billylin14/five_guys_led_cube_projection/README.md

# 5 GUYS LED Cube Projection
A real-time 3D hologram projection project with custom-made 8x8x8 LED cube interfacing with Huzzah Feather ESP32 microcontroller and LabVIEW.
