billylin14/five_guys_led_cube_projection/led_schematics/B layer.png

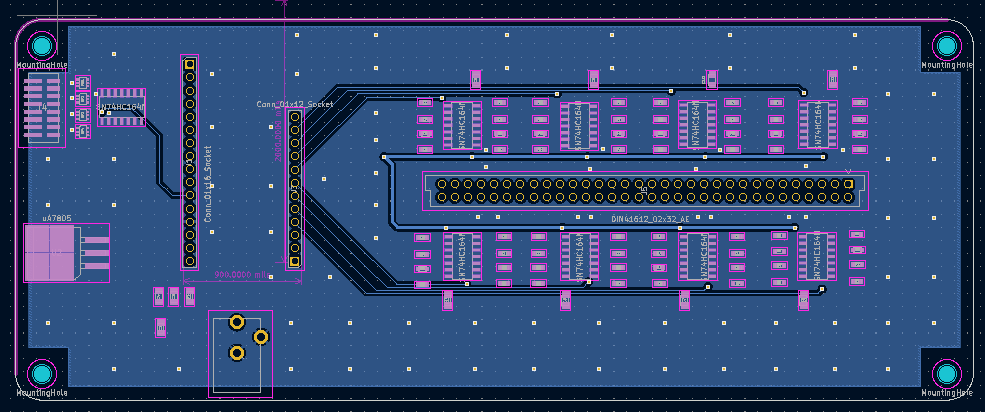
led_schematics/B layer.png
