billylin14/five_guys_led_cube_projection/led_schematics/F Layer.png

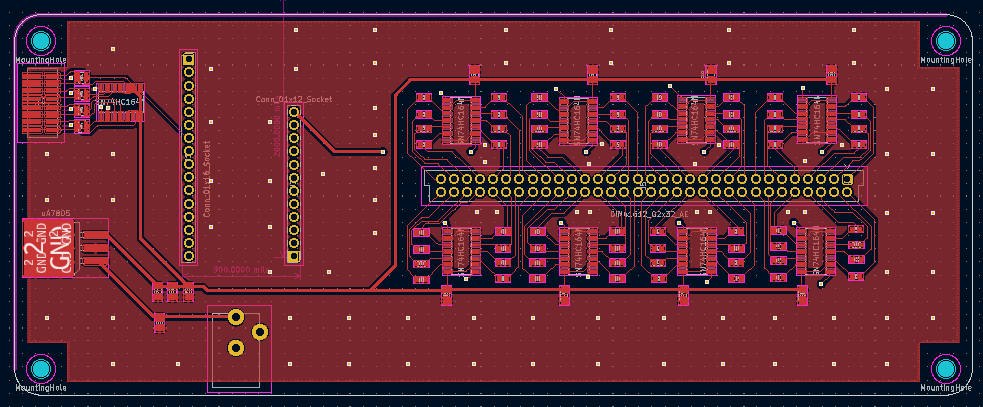
led_schematics/F Layer.png
