billylin14/five_guys_led_cube_projection/led_schematics/Full Layout.png

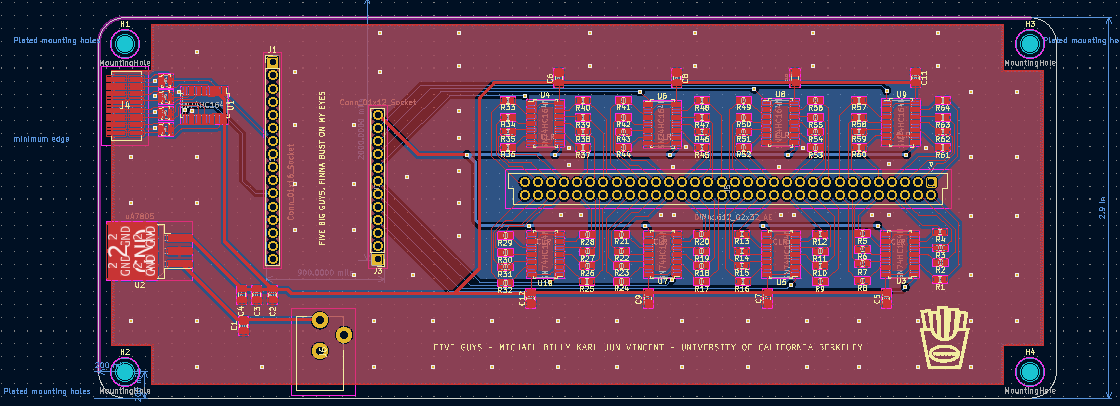
led_schematics/Full Layout.png
