billylin14/five_guys_led_cube_projection/led_schematics/Main Schmtc.png

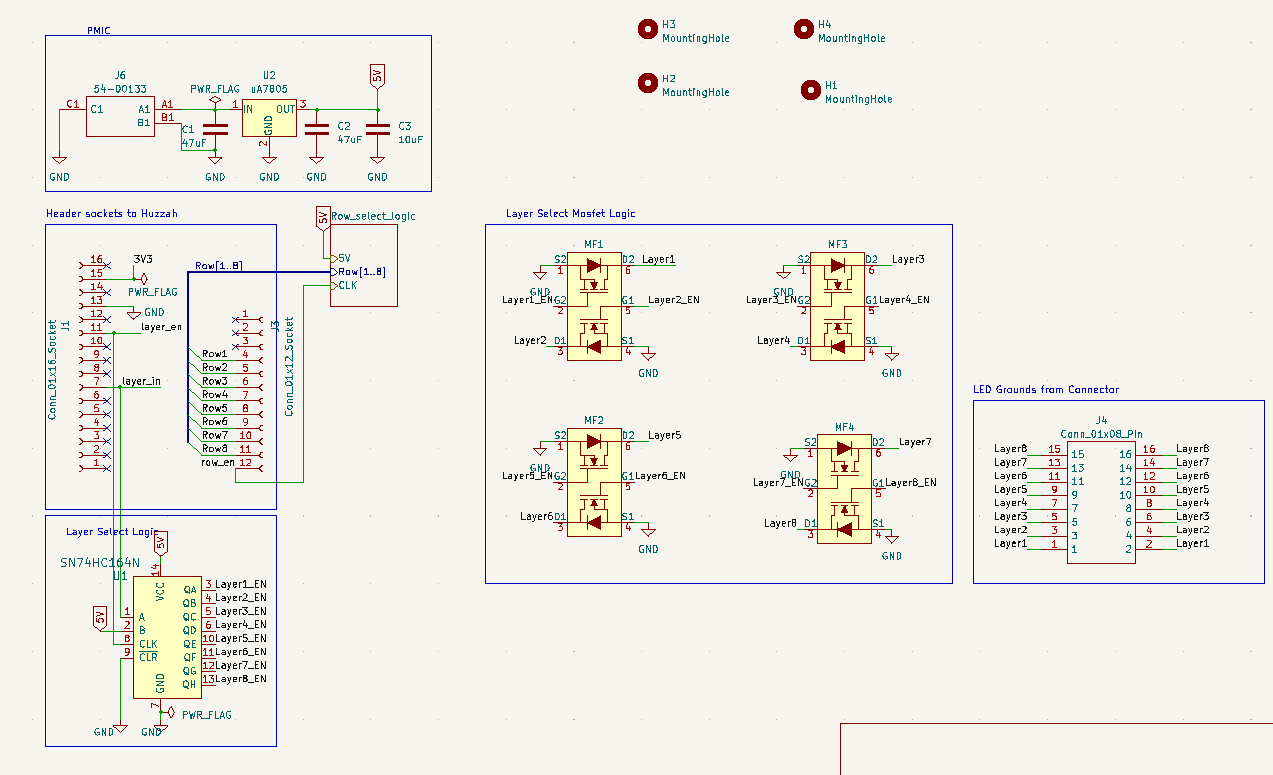
led_schematics/Main Schmtc.png
