billylin14/five_guys_led_cube_projection/led_schematics/Row_slect_logic_Schmtc.png

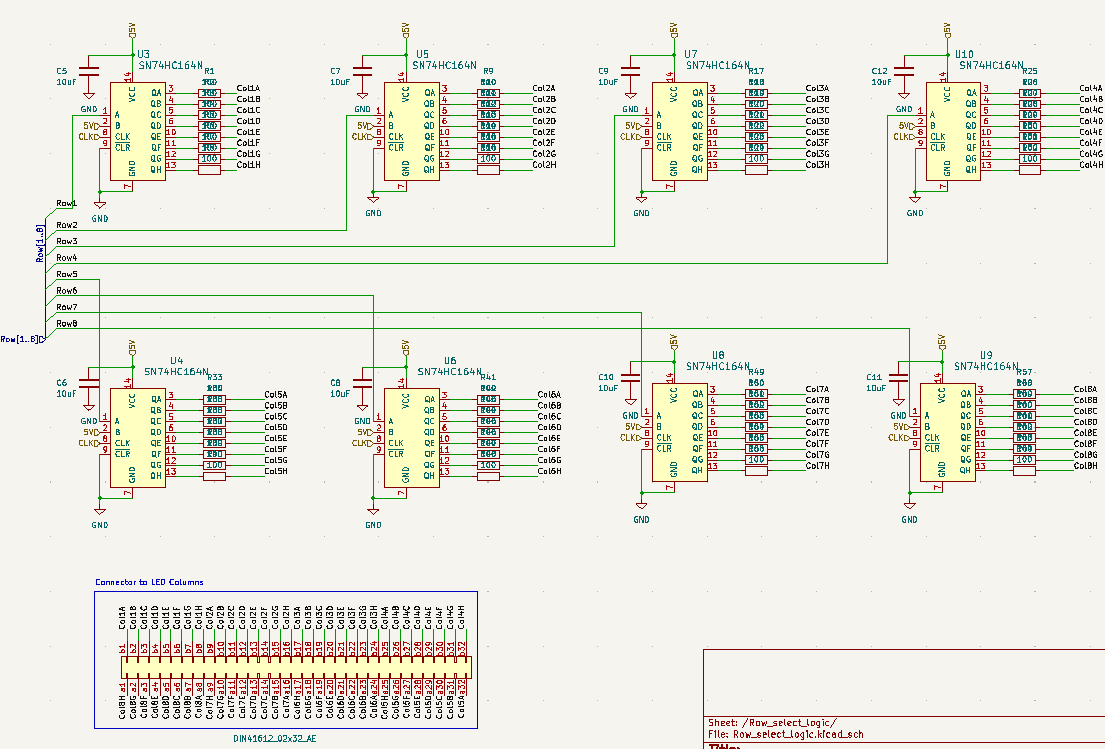
led_schematics/Row_slect_logic_Schmtc.png
