billylin14/five_guys_led_cube_projection/led_schematics/Screenshot 2023-04-14 at 12.50.28 AM.png

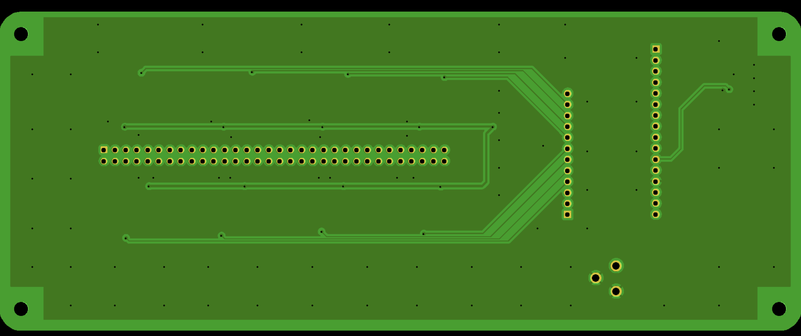
led_schematics/Screenshot 2023-04-14 at 12.50.28 AM.png
