billylin14/five_guys_led_cube_projection/led_schematics/Project BOM Template.xlsx

Custom Reference YOUR NAME (must have) + refdes (optional)! | Total Qty | Manufacturer Part # | Digi-key Part#/SKU | Mouser Part#/SKU | Price/unit ($) | Purchase URL | Reference Designator | Description (include component value if applicable) | Datasheet Link
Michael - C2,C1 | 4 | GRM31CR60J476KE19L | 490-6508-1-ND |  | 0.42 | https://www.digikey.com/en/products/detail/murata-electronics/GRM31CR60J476KE19L/2548176 | C2,C1 | 47 µF ±10% 6.3V Ceramic Capacitor X5R 1206 (3216 Metric) | https://search.murata.co.jp/Ceramy/image/img/A01X/G101/ENG/GRM31CR60J476KE19-01.pdf
Michael - C3,C5-C12 | 18 | CL21A106KOQNNNE | 1276-1096-1-ND |  | 0.074 | https://www.digikey.com/en/products/detail/samsung-electro-mechanics/CL21A106KOQNNNE/3886754 | C3,C5-C12 | 10 µF ±10% 16V Ceramic Capacitor X5R 0805 (2012 Metric) | https://media.digikey.com/pdf/Data%20Sheets/Samsung%20PDFs/CL21A106KOQNNNE_Spec.pdf
Michael - J1 | 2 | PPPC161LFBN-RC | S7049-ND |  | 1.02 | Link (https://www.digikey.com/en/products/detail/sullins-connector-solutions/PPPC161LFBN-RC/810188) | J1 | 16 Position Header Connector 0.100" (2.54mm) Through Hole Gold | Link (https://media.digikey.com/pdf/Data%20Sheets/Sullins%20PDFs/Female_Headers.100_DS.pdf)
Michael - J3 | 2 | PPPC121LFBN-RC | S7045-ND |  | 0.81 | Link (https://www.digikey.com/en/products/detail/sullins-connector-solutions/PPPC121LFBN-RC/810184) | J3 | 12 Position Header Connector 0.100" (2.54mm) Through Hole Gold | Link (https://media.digikey.com/pdf/Data%20Sheets/Sullins%20PDFs/Female_Headers.100_DS.pdf)
Michael - J4 | 2 | 874380843 | WM7652CT-ND |  | 0.91 | https://www.digikey.com/en/products/detail/molex/0874380843/699152 | J4 | Connector Header Surface Mount, Right Angle 8 position 0.059" (1.50mm) | https://www.molex.com/pdm_docs/sd/874380843_sd.pdf
Michael | 2 | 2183971082 | 900-2183971082-ND |  | 4.27 | https://www.digikey.com/en/products/detail/molex/2183971082/15518966 | None | 8 Position Cable Assembly Rectangular Socket to Cable 0.492' (150.00mm, 5.91") | https://www.molex.com/pdm_docs/sd/2183971082_sd.pdf
Michael - J5 | 2 | AWHW 64G-0202-T | AE11230-ND |  | 1.53 | https://www.digikey.com/en/products/detail/assmann-wsw-components/AWHW-64G-0202-T/5210607 | J5 | CONN HEADER VERT 64POS 2.54MM | http://www.assmann-wsw.com/uploads/datasheets/ASS_2314_CO.pdf
Michael | 2 | H1CXS-6436G | H1CXS-6436G-ND |  | 8.53 | https://www.digikey.com/en/products/detail/assmann-wsw-components/H1CXS-6436G/999193 | None | 64 Position Cable Assembly Rectangular Socket to Cable 3.00' (914.40mm) | https://media.digikey.com/pdf/Data%20Sheets/Digi-Key%20PDFs/Ribbon_Cable_Assembly_Length.pdf
Michael - J6 | 2 | 54-00133 | 839-1516-ND |  | 1.05 | https://www.digikey.com/en/products/detail/tensility-international-corp/54-00133/9685442 | J6 | Power Barrel Connector Jack 2.10mm ID (0.083"), 5.50mm OD (0.217") Through Hole, Right Angle | http://tensility.com/pdffiles/54-00133.pdf
Michael - MF1-MF4 | 7 | EM6K31GT2R | EM6K31GT2RCT-ND |  | 0.3 | https://www.digikey.com/en/products/detail/rohm-semiconductor/EM6K31GT2R/5042776 | MF1-MF4 | Mosfet Array 10.6V 500mW Through Hole 8-PDIP | https://fscdn.rohm.com/en/products/databook/datasheet/discrete/transistor/mosfet/em6k31-e.pdf
Michael | x | WP813GD | 754-1898-ND |  | 0.12962 | Link (https://www.digikey.com/en/products/detail/kingbright/WP813GD/3084264) | None | LED GREEN DIFFUSED 10MM T/H | Link (https://www.kingbrightusa.com/images/catalog/SPEC/WP813GD.pdf)
Michael - R1-R64 | 100 | CRCW060350R0FKEA | 541-3318-1-ND |  | 0.1 | https://www.digikey.com/en/products/detail/vishay-dale/CRCW060350R0FKEA/5072766 | R1-R64 | RES SMD 50 OHM 1% 1/10W 0603 | https://www.vishay.com/docs/20035/dcrcwe3.pdf
Michael - U1,U3-U10 | 12 | SN74HC164DR | 296-14838-1-ND |  | 0.53 | https://www.digikey.com/en/products/detail/texas-instruments/SN74HC164DR/562880 | U1,U3-U10 | IC 8BIT SERIAL SHIFT REG 14-SOIC | https://www.ti.com/lit/ds/scls115g/scls115g.pdf
Michael - U2 | 2 | MIC29300-5.0WU | 576-1122-ND |  | 4.96 | https://www.digikey.com/en/products/detail/microchip-technology/MIC29300-5-0WU/771591 | U2 | IC REG LINEAR 5V 3A TO263-3 | http://ww1.microchip.com/downloads/en/DeviceDoc/MIC2915x-30x-50x-75x-High-Current-Low-Dropout-Regulators-DS20005685B.pdf
