billylin14/five_guys_led_cube_projection/led_schematics/LIB_SN74HCS273PWR/SN74HCS273PWR/3D/SN74HCS273PWR.stp

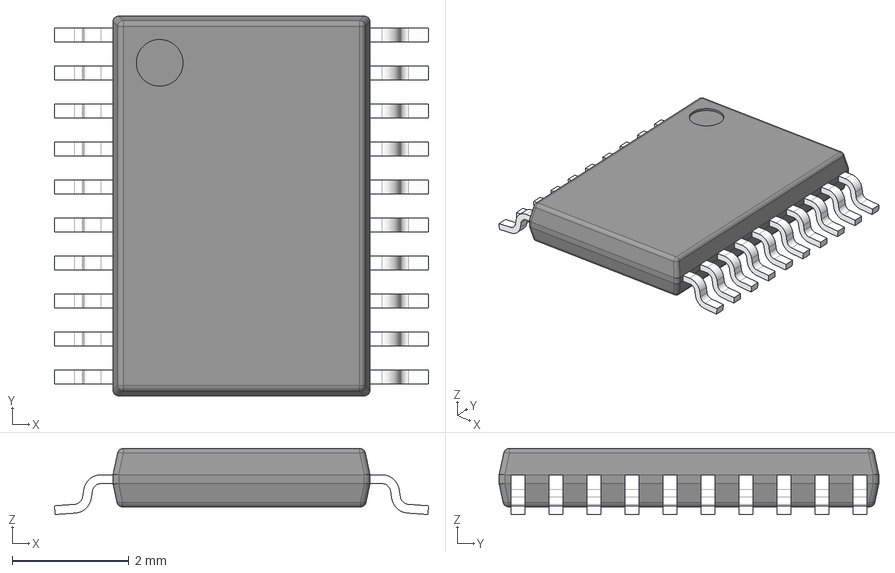
[picture p8: CAD file, 2023-04-17, last stored version]
led_schematics/LIB_SN74HCS273PWR/SN74HCS273PWR/3D/SN74HCS273PWR.stp
6.40 x 6.50 x 1.13 mm
BODY-TSSOP
LEAD-TSSOP x 20
PIN1
