billylin14/five_guys_led_cube_projection/(list of files, cad)

Other CAD files:
led_schematics/LIB_SN74HCS273PWR/SN74HCS273PWR/Allegro/sop65p640x120-20n.psm
led_schematics/LIB_SN74HCS273PWR/SN74HCS273PWR/DEHDL/sn74hcs273pwr/chips/chips.prt
