billylin14/five_guys_led_cube_projection/(list of files, drawings)

Other design files:
led_schematics/LIB_SN74HCS273PWR/SN74HCS273PWR/Altium/SN74HCS273PWR.SchLib
led_schematics/LIB_SN74HCS273PWR/SN74HCS273PWR/Altium/SOP65P640X120-20N.PcbLib
