billylin14/five_guys_led_cube_projection/led_schematics/dff_led.kicad_sch

## KiCad design led_schematics/dff_led.kicad_sch (2023-04-17, last stored version)

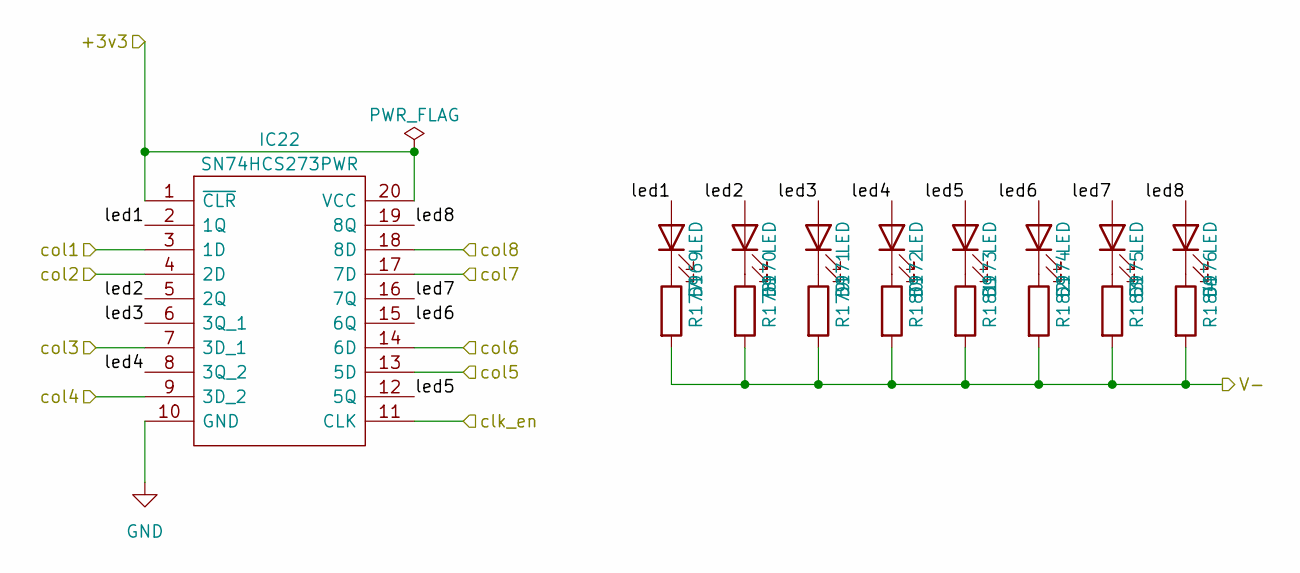
[picture p9: schematic dff_led.kicad_sch]

Parts:
D169, D170, D171, D172, D173, D174, D175, D176: LED; LED_D10.0mm
IC22: SN74HCS273PWR; SOP65P640X120-20N; Mouser Part Number 595-SN74HCS273PWR
R177, R178, R179, R180, R181, R182, R183, R184: 59; R_0603_1608Metric

Connections:
+3v3: IC22.1 (~CLR), IC22.20 (VCC)
GND: IC22.10 (GND)
unnamed: D169.1 (K), R177.1
unnamed: D170.1 (K), R178.1
unnamed: D171.1 (K), R179.1
unnamed: D172.1 (K), R180.1
unnamed: D173.1 (K), R181.1
unnamed: D174.1 (K), R182.1
unnamed: D175.1 (K), R183.1
unnamed: D176.1 (K), R184.1
V-: R177.2, R178.2, R179.2, R180.2, R181.2, R182.2, R183.2, R184.2
clk_en: IC22.11 (CLK)
col1: IC22.3 (1D)
col2: IC22.4 (2D)
col3: IC22.7 (3D_1)
col4: IC22.9 (3D_2)
col5: IC22.13 (5D)
col6: IC22.14 (6D)
col7: IC22.17 (7D)
col8: IC22.18 (8D)
led1: D169.2 (A), IC22.2 (1Q)
led2: D170.2 (A), IC22.5 (2Q)
led3: D171.2 (A), IC22.6 (3Q_1)
led4: D172.2 (A), IC22.8 (3Q_2)
led5: D173.2 (A), IC22.12 (5Q)
led6: D174.2 (A), IC22.15 (6Q)
led7: D175.2 (A), IC22.16 (7Q)
led8: D176.2 (A), IC22.19 (8Q)
