billylin14/five_guys_led_cube_projection/led_schematics/led_schematics.kicad_sch

## KiCad design led_schematics/led_schematics.kicad_sch (2023-04-17, last stored version)

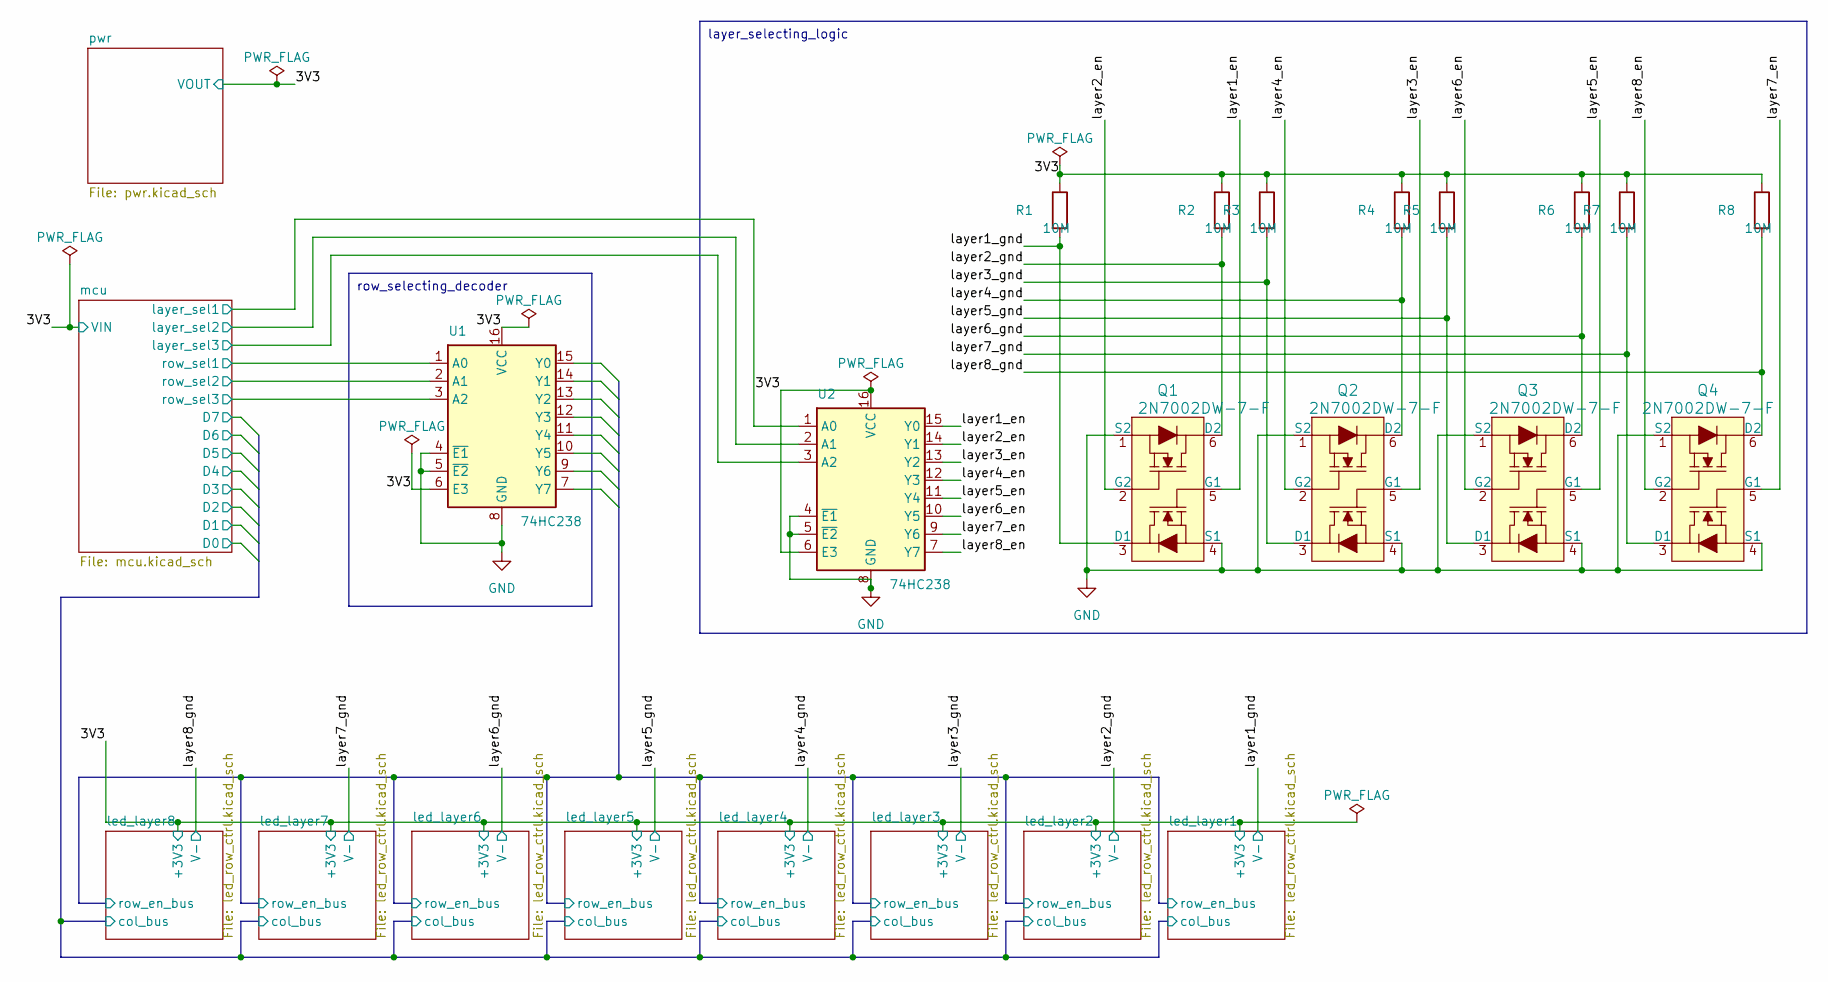
[picture p10: schematic led_schematics.kicad_sch]

Parts:
Q1, Q2, Q3, Q4: 2N7002DW-7-F; SOT-363; MPN 2N7002DW-7-F; Digi-Key_PN 2N7002DW-FDICT-ND
R1, R2, R3, R4, R5, R6, R7, R8: 10M
U1, U2: 74HC238

Connections:
3V3: R1.1, R2.1, R3.1, R4.1, R5.1, R6.1, R7.1, R8.1, U1.6 (E3), U1.16 (VCC), U2.6 (E3), U2.16 (VCC)
GND: Q1.1 (S2), Q1.4 (S1), Q2.1 (S2), Q2.4 (S1), Q3.1 (S2), Q3.4 (S1), Q4.1 (S2), Q4.4 (S1), U1.4 (~E1), U1.5 (~E2), U1.8 (GND), U2.4 (~E1), U2.5 (~E2), U2.8 (GND)
layer1_en: Q1.5 (G1), U2.15 (Y0)
layer1_gnd: Q1.3 (D1), R1.2
layer2_en: Q1.2 (G2), U2.14 (Y1)
layer2_gnd: Q1.6 (D2), R2.2
layer3_en: Q2.5 (G1), U2.13 (Y2)
layer3_gnd: Q2.3 (D1), R3.2
layer4_en: Q2.2 (G2), U2.12 (Y3)
layer4_gnd: Q2.6 (D2), R4.2
layer5_en: Q3.5 (G1), U2.11 (Y4)
layer5_gnd: Q3.3 (D1), R5.2
layer6_en: Q3.2 (G2), U2.10 (Y5)
layer6_gnd: Q3.6 (D2), R6.2
layer7_en: Q4.5 (G1), U2.9 (Y6)
layer7_gnd: Q4.3 (D1), R7.2
layer8_en: Q4.2 (G2), U2.7 (Y7)
layer8_gnd: Q4.6 (D2), R8.2
layer_sel1: U2.1 (A0)
layer_sel2: U2.2 (A1)
layer_sel3: U2.3 (A2)
row_sel1: U1.1 (A0)
row_sel2: U1.2 (A1)
row_sel3: U1.3 (A2)

Notes on the sheet:
row_selecting_decoder
layer_selecting_logic
