billylin14/five_guys_led_cube_projection/led_schematics/untitled.kicad_sch

## KiCad design led_schematics/untitled.kicad_sch (2023-04-17, last stored version)

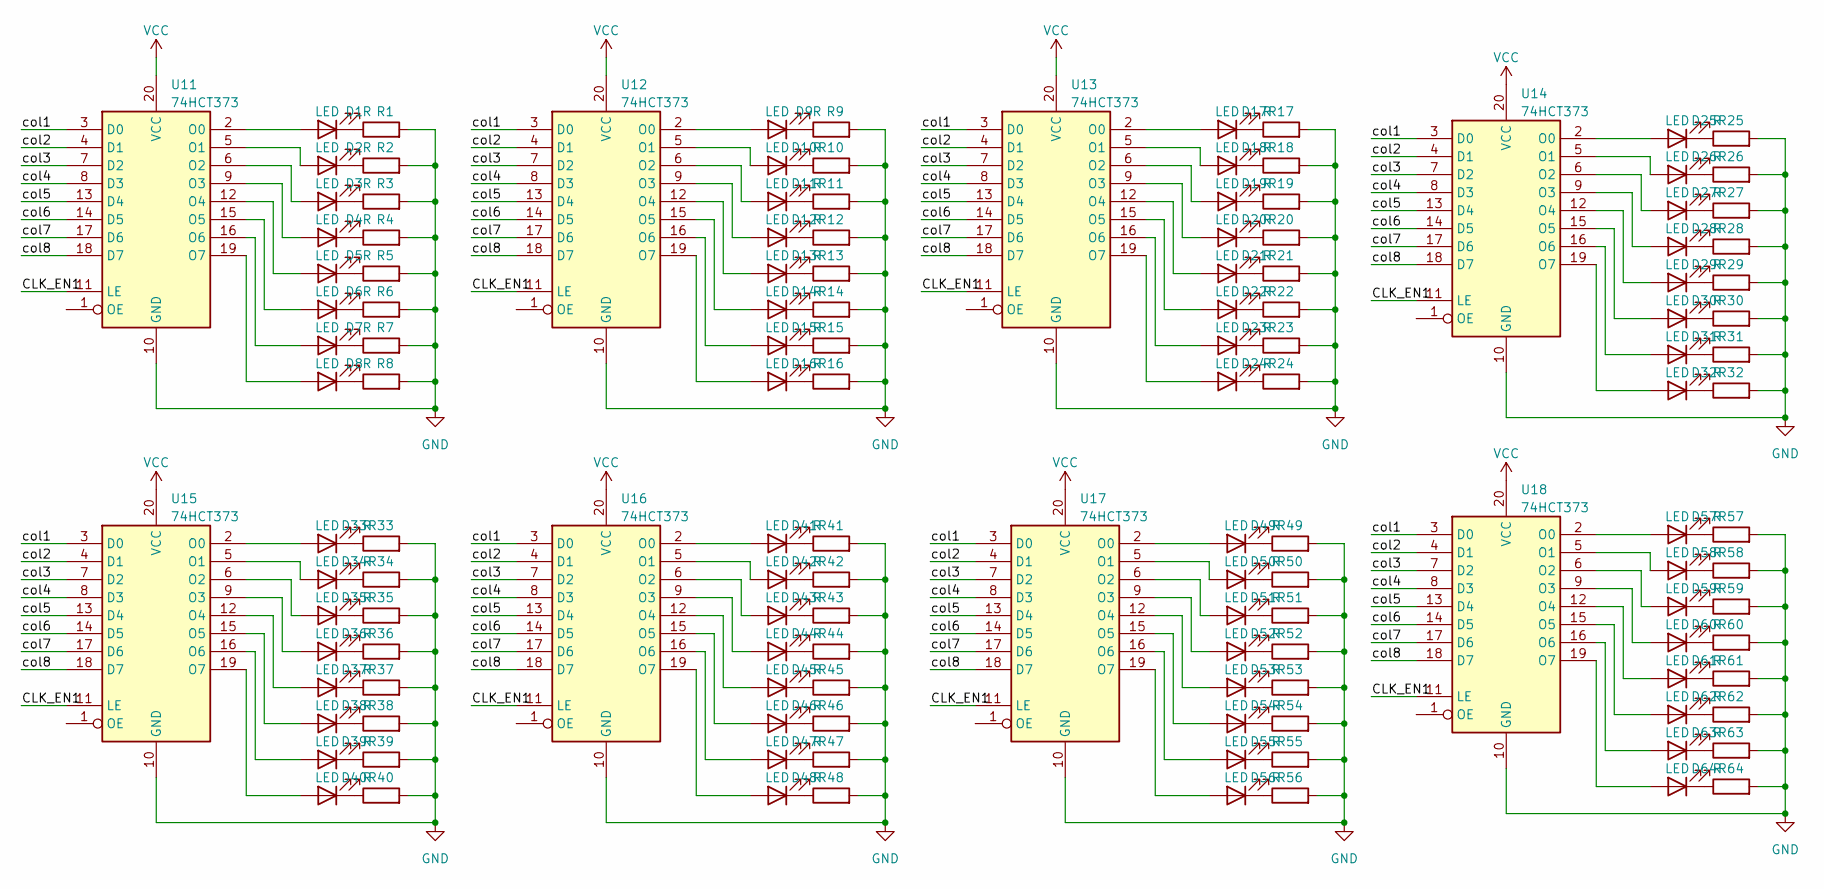
[picture p11: schematic untitled.kicad_sch]

Parts:
D1, D2, D3, D4, D5, D6, D7, D8, D9, D10, D11, D12, D13, D14, D15, D16, D17, D18, D19, D20, D21, D22, D23, D24, D25, D26, D27, D28, D29, D30, D31, D32, D33, D34, D35, D36, D37, D38, D39, D40, D41, D42, D43, D44, D45, D46, D47, D48, D49, D50, D51, D52, D53, D54, D55, D56, D57, D58, D59, D60, D61, D62, D63, D64: LED; LED_D10.0mm
R1, R2, R3, R4, R5, R6, R7, R8, R9, R10, R11, R12, R13, R14, R15, R16, R17, R18, R19, R20, R21, R22, R23, R24, R25, R26, R27, R28, R29, R30, R31, R32, R33, R34, R35, R36, R37, R38, R39, R40, R41, R42, R43, R44, R45, R46, R47, R48, R49, R50, R51, R52, R53, R54, R55, R56, R57, R58, R59, R60, R61, R62, R63, R64: R; R_0603_1608Metric
U11, U12, U13, U14, U15, U16, U17, U18: 74HCT373; TSSOP-20_4.4x6.5mm_P0.65mm

Connections:
CLK_EN1: U11.11 (LE), U12.11 (LE), U13.11 (LE), U14.11 (LE), U15.11 (LE), U16.11 (LE), U17.11 (LE), U18.11 (LE)
GND: R1.2, R2.2, R3.2, R4.2, R5.2, R6.2, R7.2, R8.2, R9.2, R10.2, R11.2, R12.2, R13.2, R14.2, R15.2, R16.2, R17.2, R18.2, R19.2, R20.2, R21.2, R22.2, R23.2, R24.2, R25.2, R26.2, R27.2, R28.2, R29.2, R30.2, R31.2, R32.2, R33.2, R34.2, R35.2, R36.2, R37.2, R38.2, R39.2, R40.2, R41.2, R42.2, R43.2, R44.2, R45.2, R46.2, R47.2, R48.2, R49.2, R50.2, R51.2, R52.2, R53.2, R54.2, R55.2, R56.2, R57.2, R58.2, R59.2, R60.2, R61.2, R62.2, R63.2, R64.2, U11.10 (GND), U12.10 (GND), U13.10 (GND), U14.10 (GND), U15.10 (GND), U16.10 (GND), U17.10 (GND), U18.10 (GND)
unnamed: D1.1 (K), R1.1
unnamed: D1.2 (A), U11.2 (O0)
unnamed: D2.1 (K), R2.1
unnamed: D2.2 (A), U11.5 (O1)
unnamed: D3.1 (K), R3.1
unnamed: D3.2 (A), U11.6 (O2)
unnamed: D4.1 (K), R4.1
unnamed: D4.2 (A), U11.9 (O3)
unnamed: D5.1 (K), R5.1
unnamed: D5.2 (A), U11.12 (O4)
unnamed: D6.1 (K), R6.1
unnamed: D6.2 (A), U11.15 (O5)
unnamed: D7.1 (K), R7.1
unnamed: D7.2 (A), U11.16 (O6)
unnamed: D8.1 (K), R8.1
unnamed: D8.2 (A), U11.19 (O7)
unnamed: D9.1 (K), R9.1
unnamed: D9.2 (A), U12.2 (O0)
unnamed: D10.1 (K), R10.1
unnamed: D10.2 (A), U12.5 (O1)
unnamed: D11.1 (K), R11.1
unnamed: D11.2 (A), U12.6 (O2)
unnamed: D12.1 (K), R12.1
unnamed: D12.2 (A), U12.9 (O3)
unnamed: D13.1 (K), R13.1
unnamed: D13.2 (A), U12.12 (O4)
unnamed: D14.1 (K), R14.1
unnamed: D14.2 (A), U12.15 (O5)
unnamed: D15.1 (K), R15.1
unnamed: D15.2 (A), U12.16 (O6)
unnamed: D16.1 (K), R16.1
unnamed: D16.2 (A), U12.19 (O7)
unnamed: D17.1 (K), R17.1
unnamed: D17.2 (A), U13.2 (O0)
unnamed: D18.1 (K), R18.1
unnamed: D18.2 (A), U13.5 (O1)
unnamed: D19.1 (K), R19.1
unnamed: D19.2 (A), U13.6 (O2)
unnamed: D20.1 (K), R20.1
unnamed: D20.2 (A), U13.9 (O3)
unnamed: D21.1 (K), R21.1
unnamed: D21.2 (A), U13.12 (O4)
unnamed: D22.1 (K), R22.1
unnamed: D22.2 (A), U13.15 (O5)
unnamed: D23.1 (K), R23.1
unnamed: D23.2 (A), U13.16 (O6)
unnamed: D24.1 (K), R24.1
unnamed: D24.2 (A), U13.19 (O7)
unnamed: D25.1 (K), R25.1
unnamed: D25.2 (A), U14.2 (O0)
unnamed: D26.1 (K), R26.1
unnamed: D26.2 (A), U14.5 (O1)
unnamed: D27.1 (K), R27.1
unnamed: D27.2 (A), U14.6 (O2)
unnamed: D28.1 (K), R28.1
unnamed: D28.2 (A), U14.9 (O3)
unnamed: D29.1 (K), R29.1
unnamed: D29.2 (A), U14.12 (O4)
unnamed: D30.1 (K), R30.1
unnamed: D30.2 (A), U14.15 (O5)
unnamed: D31.1 (K), R31.1
unnamed: D31.2 (A), U14.16 (O6)
unnamed: D32.1 (K), R32.1
unnamed: D32.2 (A), U14.19 (O7)
unnamed: D33.1 (K), R33.1
unnamed: D33.2 (A), U15.2 (O0)
unnamed: D34.1 (K), R34.1
unnamed: D34.2 (A), U15.5 (O1)
unnamed: D35.1 (K), R35.1
unnamed: D35.2 (A), U15.6 (O2)
unnamed: D36.1 (K), R36.1
unnamed: D36.2 (A), U15.9 (O3)
unnamed: D37.1 (K), R37.1
unnamed: D37.2 (A), U15.12 (O4)
unnamed: D38.1 (K), R38.1
unnamed: D38.2 (A), U15.15 (O5)
unnamed: D39.1 (K), R39.1
unnamed: D39.2 (A), U15.16 (O6)
unnamed: D40.1 (K), R40.1
unnamed: D40.2 (A), U15.19 (O7)
unnamed: D41.1 (K), R41.1
unnamed: D41.2 (A), U16.2 (O0)
unnamed: D42.1 (K), R42.1
unnamed: D42.2 (A), U16.5 (O1)
unnamed: D43.1 (K), R43.1
unnamed: D43.2 (A), U16.6 (O2)
unnamed: D44.1 (K), R44.1
unnamed: D44.2 (A), U16.9 (O3)
unnamed: D45.1 (K), R45.1
unnamed: D45.2 (A), U16.12 (O4)
unnamed: D46.1 (K), R46.1
unnamed: D46.2 (A), U16.15 (O5)
unnamed: D47.1 (K), R47.1
unnamed: D47.2 (A), U16.16 (O6)
unnamed: D48.1 (K), R48.1
unnamed: D48.2 (A), U16.19 (O7)
unnamed: D49.1 (K), R49.1
unnamed: D49.2 (A), U17.2 (O0)
unnamed: D50.1 (K), R50.1
unnamed: D50.2 (A), U17.5 (O1)
unnamed: D51.1 (K), R51.1
unnamed: D51.2 (A), U17.6 (O2)
unnamed: D52.1 (K), R52.1
unnamed: D52.2 (A), U17.9 (O3)
unnamed: D53.1 (K), R53.1
unnamed: D53.2 (A), U17.12 (O4)
unnamed: D54.1 (K), R54.1
unnamed: D54.2 (A), U17.15 (O5)
unnamed: D55.1 (K), R55.1
unnamed: D55.2 (A), U17.16 (O6)
unnamed: D56.1 (K), R56.1
unnamed: D56.2 (A), U17.19 (O7)
unnamed: D57.1 (K), R57.1
unnamed: D57.2 (A), U18.2 (O0)
unnamed: D58.1 (K), R58.1
unnamed: D58.2 (A), U18.5 (O1)
unnamed: D59.1 (K), R59.1
unnamed: D59.2 (A), U18.6 (O2)
unnamed: D60.1 (K), R60.1
unnamed: D60.2 (A), U18.9 (O3)
unnamed: D61.1 (K), R61.1
unnamed: D61.2 (A), U18.12 (O4)
unnamed: D62.1 (K), R62.1
unnamed: D62.2 (A), U18.15 (O5)
unnamed: D63.1 (K), R63.1
unnamed: D63.2 (A), U18.16 (O6)
unnamed: D64.1 (K), R64.1
unnamed: D64.2 (A), U18.19 (O7)
VCC: U11.20 (VCC), U12.20 (VCC), U13.20 (VCC), U14.20 (VCC), U15.20 (VCC), U16.20 (VCC), U17.20 (VCC), U18.20 (VCC)
col1: U11.3 (D0), U12.3 (D0), U13.3 (D0), U14.3 (D0), U15.3 (D0), U16.3 (D0), U17.3 (D0), U18.3 (D0)
col2: U11.4 (D1), U12.4 (D1), U13.4 (D1), U14.4 (D1), U15.4 (D1), U16.4 (D1), U17.4 (D1), U18.4 (D1)
col3: U11.7 (D2), U12.7 (D2), U13.7 (D2), U14.7 (D2), U15.7 (D2), U16.7 (D2), U17.7 (D2), U18.7 (D2)
col4: U11.8 (D3), U12.8 (D3), U13.8 (D3), U14.8 (D3), U15.8 (D3), U16.8 (D3), U17.8 (D3), U18.8 (D3)
col5: U11.13 (D4), U12.13 (D4), U13.13 (D4), U14.13 (D4), U15.13 (D4), U16.13 (D4), U17.13 (D4), U18.13 (D4)
col6: U11.14 (D5), U12.14 (D5), U13.14 (D5), U14.14 (D5), U15.14 (D5), U16.14 (D5), U17.14 (D5), U18.14 (D5)
col7: U11.17 (D6), U12.17 (D6), U13.17 (D6), U14.17 (D6), U15.17 (D6), U16.17 (D6), U17.17 (D6), U18.17 (D6)
col8: U11.18 (D7), U12.18 (D7), U13.18 (D7), U14.18 (D7), U15.18 (D7), U16.18 (D7), U17.18 (D7), U18.18 (D7)
