billylin14/five_guys_led_cube_projection/led_freeRTOS_final/src/pin_def.h

#ifndef PIN_DEF_H
#define PIN_DEF_H

// define pin outs
#define Layer 25
#define Row1 13
#define Row2 12
#define Row3 27
#define Row4 33
#define Row5 15
#define Row6 32
#define Row7 14
#define Row8 22
#define row_clk 21
#define layer_clk 5

void pin_init();

#endif
