billylin14/five_guys_led_cube_projection/led_freeRTOS_final/src/tasks/flash.h

#ifndef DATA_TYPES
#define DATA_TYPES
#include "../data.h"
#endif

#ifndef FLASH_H
#define FLASH_H

#define GetBit(var, bit) ((var & (1 << bit)) != 0) //Get bit in byte function

extern TaskHandle_t flash_handle;

void flash_task(void *pvParameters);
void layer_write(BitLayerBuff *bitBufs);

#endif
