billylin14/five_guys_led_cube_projection/led_freeRTOS_final/src/tasks/generate.cpp

#include <Arduino.h>

#include "../project_setting.h"
#include "generate.h"

TaskHandle_t generate_handle;

void generate_task(void *pvParameters) {
  const TickType_t xDelay = 1;
  uint8_t currLayer = 0;
  bitset_t tempBuffer[ROW_SIZE];

  while (1) {
    #if LOGGING 
    Serial.println("Enters generate task");
    #endif
    #if GENERATE_TASK_EN
    xSemaphoreTake(coordBufs[currLayer].mutex, portMAX_DELAY); 
    fill_temp_buffer_with_coords(tempBuffer, &coordBufs[currLayer]); 
    xSemaphoreGive(coordBufs[currLayer].mutex);
    
    #if LOGGING
    Serial.printf("Generate function ran %d layer \n", currLayer);
    #endif

    xSemaphoreTake(bitBufs[currLayer].mutex, portMAX_DELAY);
    for (int i = 0; i < ROW_SIZE; i++) {
        bitBufs[currLayer].buff[i] = tempBuffer[i];

    }
    xSemaphoreGive(bitBufs[currLayer].mutex);

    //update layer for every loop
    if (currLayer >= LAYER_SIZE-1) {
        currLayer = 0;

    } else {
        currLayer++;

    }
    #endif
    vTaskDelay(xDelay); 
  }
}

void clear_bit(bitset_t *bitset, int pos) {
    *bitset &= ~(1ull << pos);
}

bool is_bit_set(bitset_t *bitset, int pos) {
    return (*bitset & (1ull << pos)) != 0;
}
//layer_points is a struct of x,y with 8 by 64 array.

void fill_temp_buffer_with_coords(bitset_t tempBuffer[ROW_SIZE], CoordBuff *coordBuff) {
    for (int i = 0; i < ROW_SIZE; i++) {
        tempBuffer[i] = 0;
    }

    for (int i = 0; i < coordBuff->point_count; i++) {
        int x = coordBuff->points[i].x;
        int y = coordBuff->points[i].y;
        SetBitOn(tempBuffer[x], y);
    }
}
