billylin14/five_guys_led_cube_projection/(commit log)

2023-04-17 initial commit of schematics and layouts (02/23/2023)
    [EDI2CAP.CFG, SN74HCS273PWR.SchLib, SN74HCS273PWR.stp, SOP65P640X120-20N.PcbLib, chips.prt, column_decoder.kicad_sch, decoder.kicad_sch, dff_led.kicad_sch]
2023-04-29 Updated freeRTOS skeleton code to process_serial_string function
    [EDI2CAP.CFG, Project BOM Template.xlsx, SN74HCS273PWR.SchLib, SN74HCS273PWR.stp, SOP65P640X120-20N.PcbLib, chips.prt, column_decoder.kicad_sch, decoder.kicad_sch]
2023-04-30 Printing generate task outputs
2023-05-03 final completed freeRTOS prototype
